BTSC10/WarpESC/README.md

# WarpESC
An open source 2 channel 50A ESC designed for a 2-4S LiPo Battery.
The design utilises a STM32F303 and 6 SIC634CD-T1-GE3 power stages to produce the 3 phase voltages.
