BTSC10/WarpESC/Kicad_Files/WarpESC.kicad_pcb

## KiCad design Kicad_Files/WarpESC.kicad_pcb (2022-10-20)

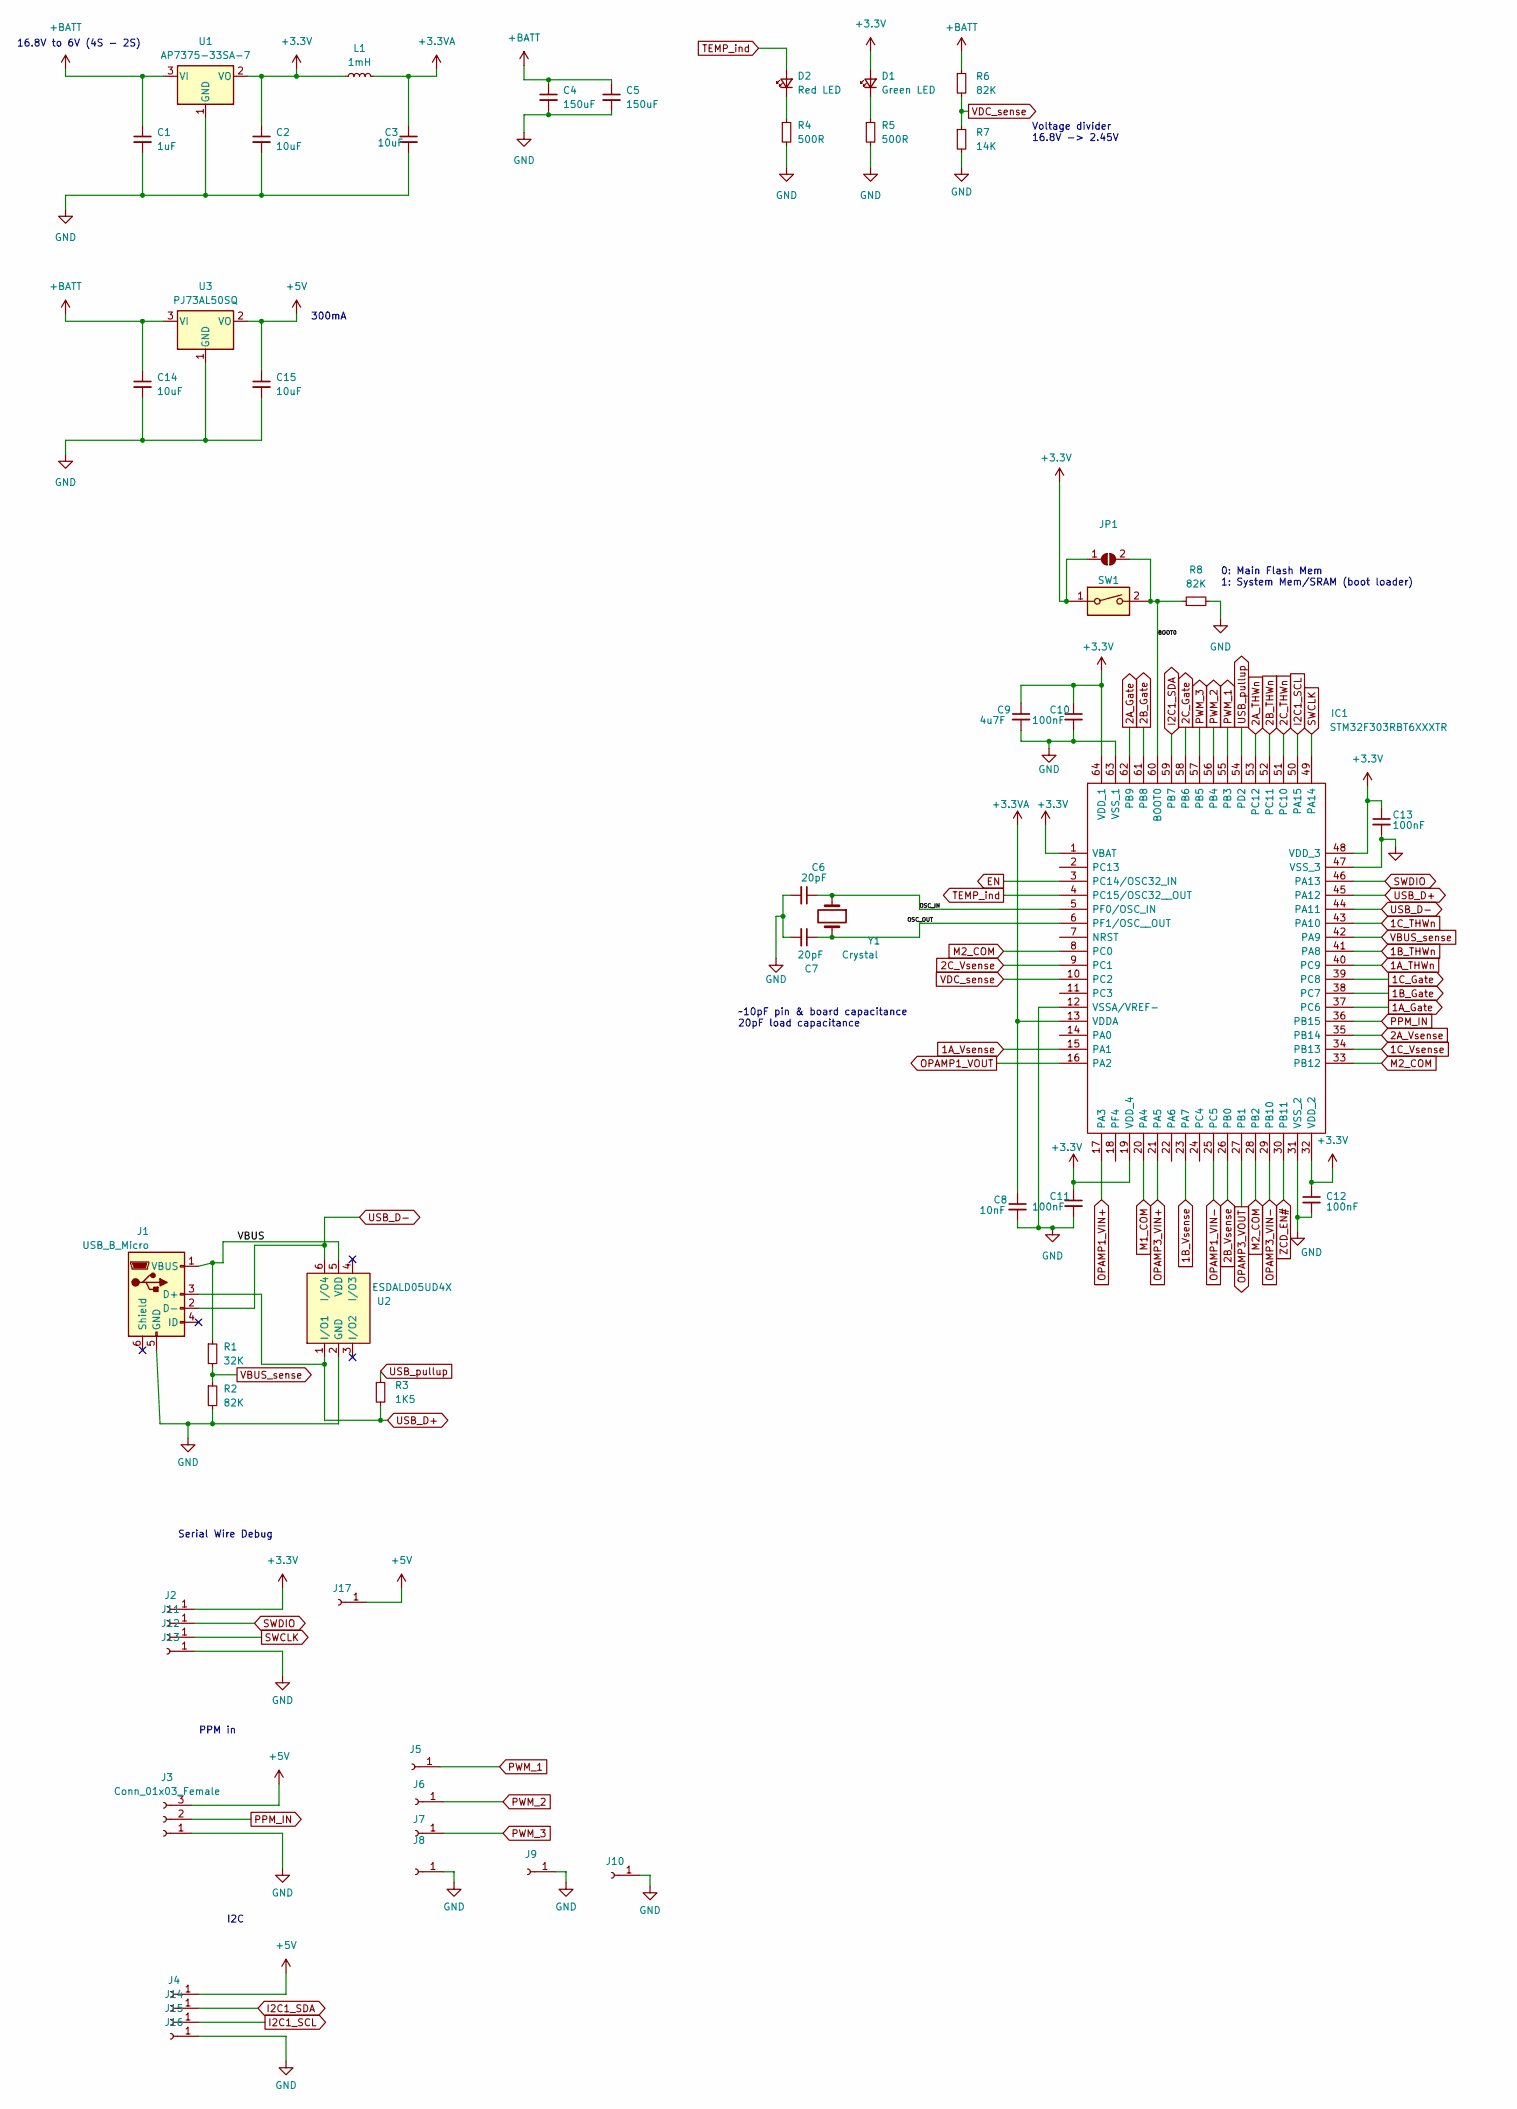
[picture p1: schematic WarpESC.kicad_sch, part in row 1, column 1]

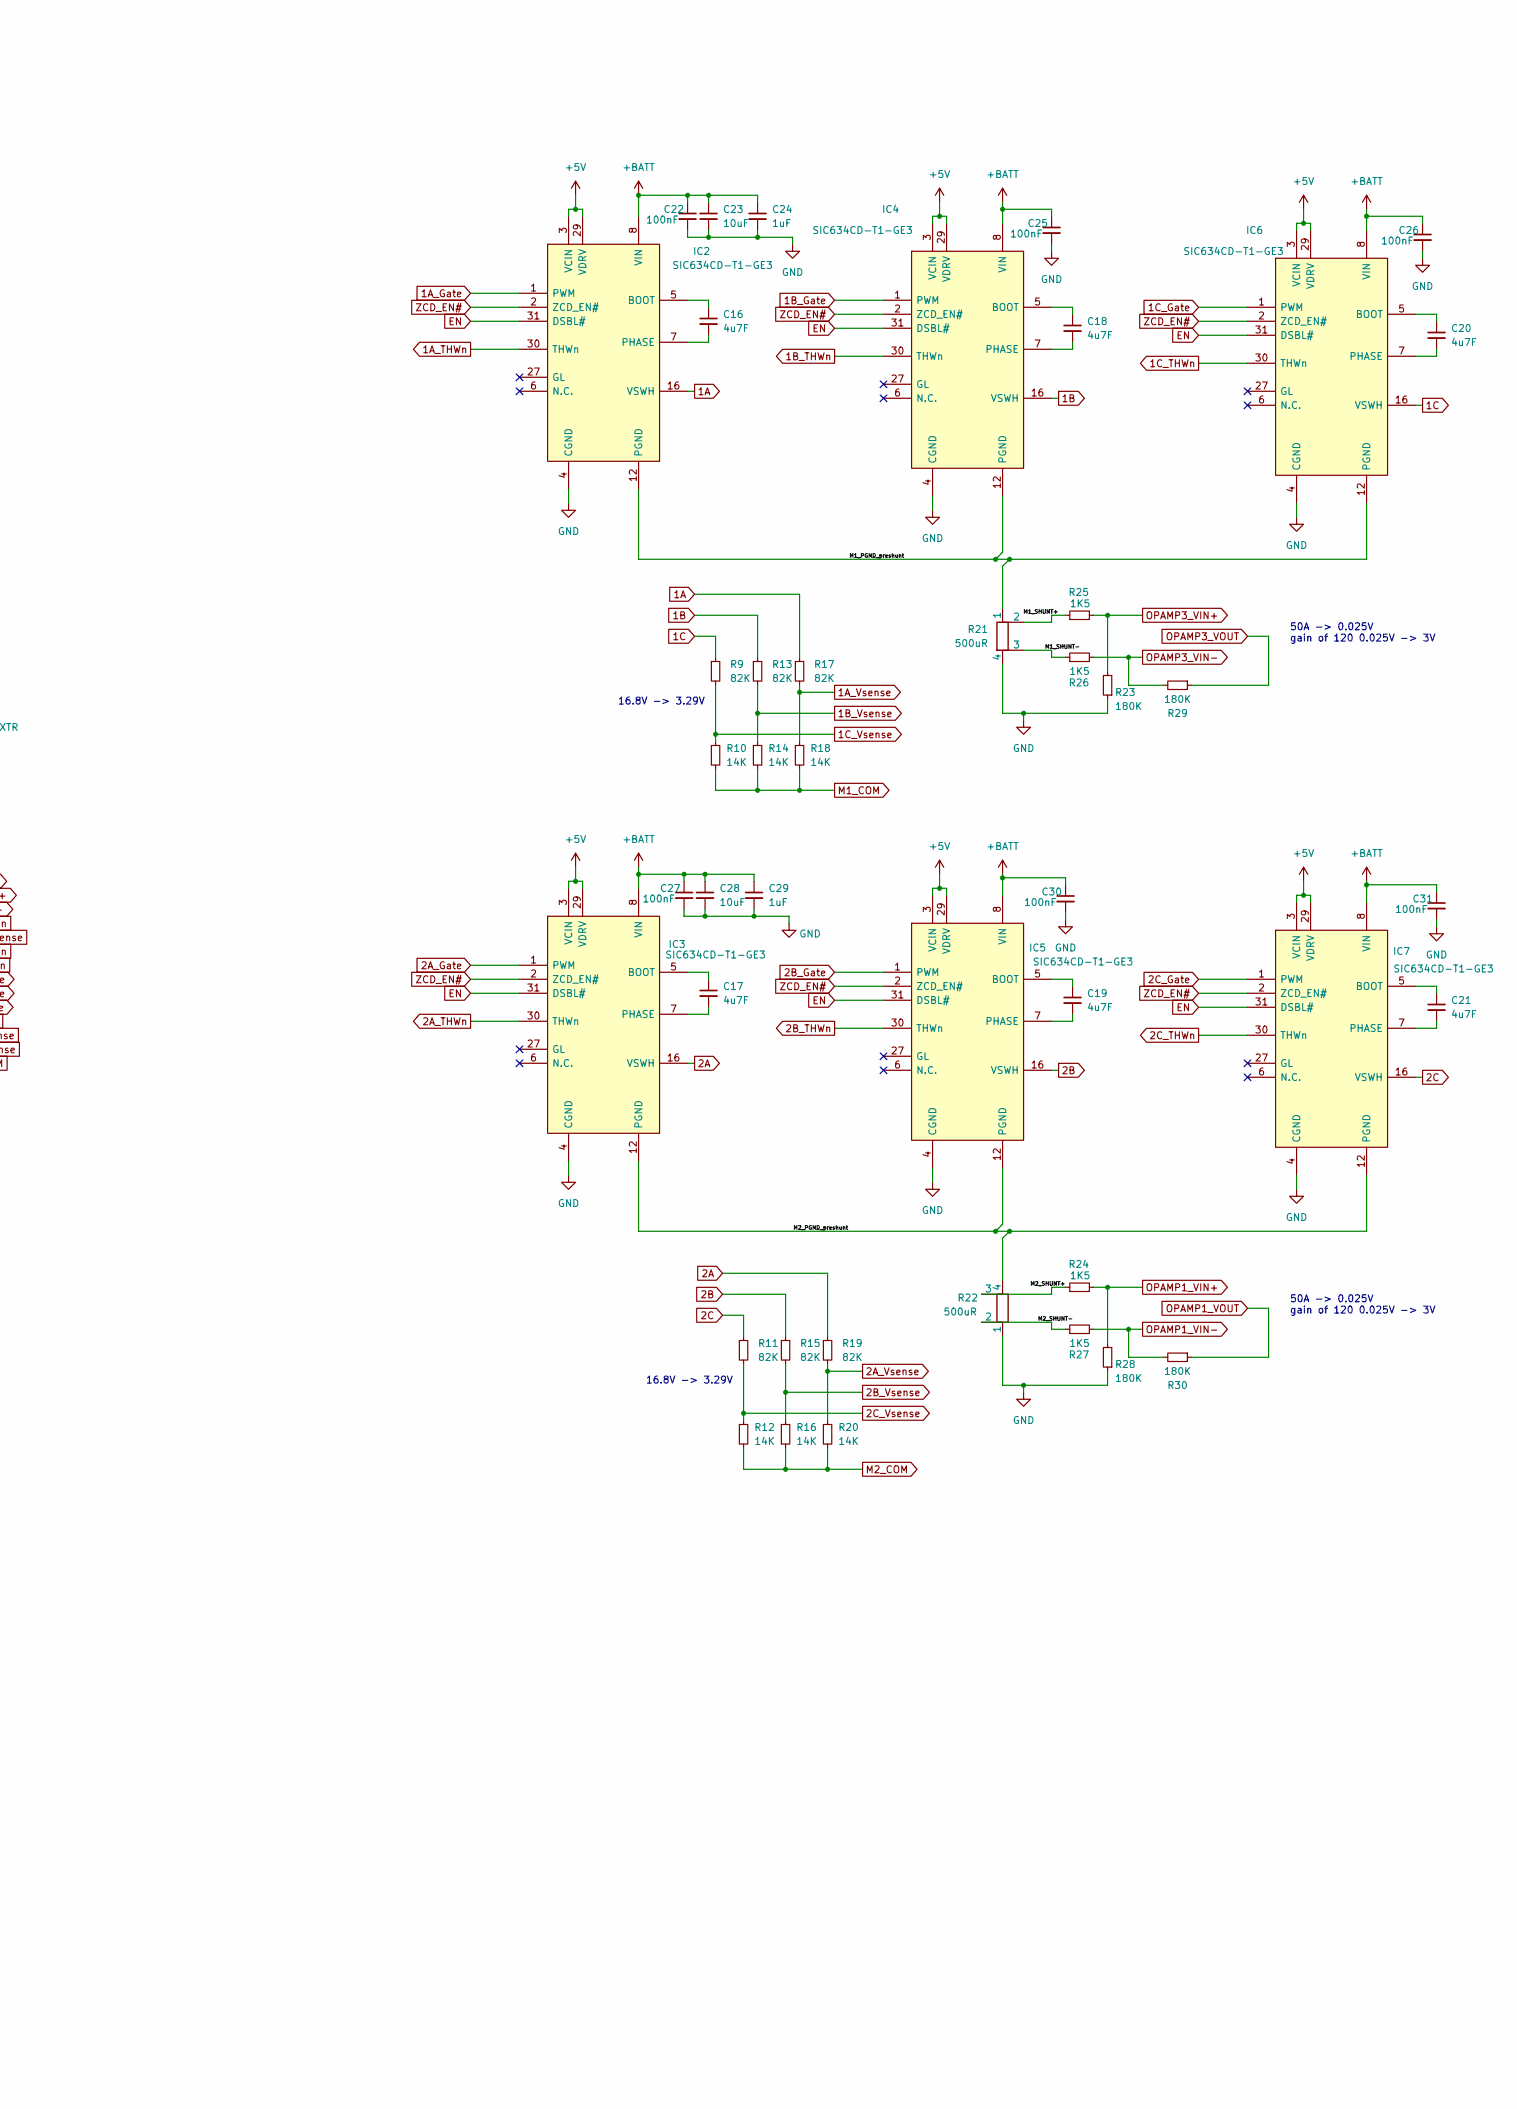
[picture p2: schematic WarpESC.kicad_sch, part in row 1, column 2]

Parts:
C1, C24, C29: 1uF; C_0805_2012Metric
C2, C3, C15: 10uF; C_0402_1005Metric
C4, C5: 150uF
C6, C7: 20pF; C_0402_1005Metric
C8: 10nF; C_0402_1005Metric
C9: 4u7F; C_0603_1608Metric
C10, C11, C12, C13, C22, C25, C26, C27, C30, C31: 100nF; C_0402_1005Metric
C14, C23, C28: 10uF; C_1206_3216Metric
C16, C17, C18, C19, C20, C21: 4u7F; C_0402_1005Metric
D1: Green LED; LED_0603_1608Metric
D2: Red LED; LED_0603_1608Metric
IC1: STM32F303RBT6XXXTR; LQFP-64_10x10mm_P0.5mm; Manufacturer_Part_Number STM32F303RBT6XXXTR
IC2, IC3, IC4, IC5, IC6, IC7: SIC634CD-T1-GE3; SIC634CDT1GE3; Manufacturer_Part_Number SIC634CD-T1-GE3; Mouser Part Number 78-SIC634CD-T1-GE3
J1: USB_B_Micro; USB-MR-D-015
J2, J4, J5, J6, J7, J8, J9, J10, J12, J13, J15, J16, J17: Conn_01x01_Female; SolderWirePad_1x01_SMD_1x2mm
J3: Conn_01x03_Female; PinHeader_1x03_P2.54mm_Vertical
J11, J14: VV; SolderWirePad_1x01_SMD_1x2mm
JP1: SolderJumper_2_Open; SolderJumper-2_P1.3mm_Open_RoundedPad1.0x1.5mm
L1: 1mH; L_1210_3225Metric
R1: 32K; R_0402_1005Metric
R2, R6, R8, R9, R11, R13, R15, R17, R19: 82K; R_0402_1005Metric
R3, R24, R25, R26, R27: 1K5; R_0402_1005Metric
R4, R5: 500R; R_0805_2012Metric
R7, R10, R12, R14, R16, R18, R20: 14K; R_0402_1005Metric
R21, R22: 500uR; WSK12161L000FEA
R23, R28, R29, R30: 180K; R_0402_1005Metric
SW1: DS04-254-2-01BK-SMT; DS04-254-SMT
U1: AP7375-33SA-7; SOT-23
U2: ESDALD05UD4X; SOT-23-6
U3: PJ73AL50SQ; SOT-89-3
Y1: Crystal; Crystal_SMD_3225-4Pin_3.2x2.5mm

Connections:
1A: IC2.16 (VSWH), R17.1
1A_Gate: IC1.37 (PC6), IC2.1 (PWM)
1A_THWn: IC1.40 (PC9), IC2.30 (THWn)
1A_Vsense: IC1.15 (PA1), R17.2, R18.1
1B: IC4.16 (VSWH), R13.1
1B_Gate: IC1.38 (PC7), IC4.1 (PWM)
1B_THWn: IC1.41 (PA8), IC4.30 (THWn)
1B_Vsense: IC1.23 (PA7), R13.2, R14.1
1C: IC6.16 (VSWH), R9.1
1C_Gate: IC1.39 (PC8), IC6.1 (PWM)
1C_THWn: IC1.43 (PA10), IC6.30 (THWn)
1C_Vsense: IC1.34 (PB13), R9.2, R10.1
2A: IC3.16 (VSWH), R19.1
2A_Gate: IC1.62 (PB9), IC3.1 (PWM)
2A_THWn: IC1.53 (PC12), IC3.30 (THWn)
2A_Vsense: IC1.35 (PB14), R19.2, R20.1
2B: IC5.16 (VSWH), R15.1
2B_Gate: IC1.61 (PB8), IC5.1 (PWM)
2B_THWn: IC1.52 (PC11), IC5.30 (THWn)
2B_Vsense: IC1.26 (PB0), R15.2, R16.1
2C: IC7.16 (VSWH), R11.1
2C_Gate: IC1.58 (PB6), IC7.1 (PWM)
2C_THWn: IC1.51 (PC10), IC7.30 (THWn)
2C_Vsense: IC1.9 (PC1), R11.2, R12.1
+3.3VA: C3.1, C8.1, IC1.13 (VDDA), L1.2
+3V3: C2.1, C9.1, C10.1, C11.1, C12.1, C13.1, D1.2 (A), IC1.1 (VBAT), IC1.19 (VDD_4), IC1.32 (VDD_2), IC1.48 (VDD_3), IC1.64 (VDD_1), J2.1, JP1.1 (A), L1.1, SW1.1, U1.2 (VO)
+5V: C15.1, IC2.3 (VCIN), IC2.29 (VDRV), IC3.3 (VCIN), IC3.29 (VDRV), IC4.3 (VCIN), IC4.29 (VDRV), IC5.3 (VCIN), IC5.29 (VDRV), IC6.3 (VCIN), IC6.29 (VDRV), IC7.3 (VCIN), IC7.29 (VDRV), J3.3, J4.1, J17.1, U3.2 (VO)
+BATT: C1.1, C4.1, C5.1, C14.1, C22.1, C23.1, C24.1, C25.1, C26.1, C27.1, C28.1, C29.1, C30.1, C31.1, IC2.8 (VIN), IC3.8 (VIN), IC4.8 (VIN), IC5.8 (VIN), IC6.8 (VIN), IC7.8 (VIN), R6.1, U1.3 (VI), U3.3 (VI)
/BOOT0: IC1.60 (BOOT0), JP1.2 (B), R8.1, SW1.2
/M1_PGND_preshunt: IC2.12 (PGND), IC4.12 (PGND), IC6.12 (PGND), R21.1
/M1_SHUNT+: R21.2, R25.1
/M1_SHUNT-: R21.3, R26.1
/M2_PGND_preshunt: IC3.12 (PGND), IC5.12 (PGND), IC7.12 (PGND), R22.4
/M2_SHUNT+: R22.3, R24.1
/M2_SHUNT-: R22.2, R27.1
/OSC_IN: C6.1, IC1.5 (PF0/OSC_IN), Y1.1
/OSC_OUT: C7.1, IC1.6 (PF1/OSC__OUT), Y1.3
/VBUS: J1.1 (VBUS), R1.1, U2.5 (VDD)
EN: IC1.3 (PC14/OSC32_IN), IC2.31 (DSBL#), IC3.31 (DSBL#), IC4.31 (DSBL#), IC5.31 (DSBL#), IC6.31 (DSBL#), IC7.31 (DSBL#)
GND: C1.2, C2.2, C3.2, C4.2, C5.2, C6.2, C7.2, C8.2, C9.2, C10.2, C11.2, C12.2, C13.2, C14.2, C15.2, C22.2, C23.2, C24.2, C25.2, C26.2, C27.2, C28.2, C29.2, C30.2, C31.2, IC1.12 (VSSA/VREF-), IC1.31 (VSS_2), IC1.47 (VSS_3), IC1.63 (VSS_1), IC2.4 (CGND), IC3.4 (CGND), IC4.4 (CGND), IC5.4 (CGND), IC6.4 (CGND), IC7.4 (CGND), J1.5 (GND), J3.1, J8.1, J9.1, J10.1, J13.1, J16.1, R2.2, R4.2, R5.2, R7.2, R8.2, R21.4, R22.1, R23.1, R28.1, U1.1 (GND), U2.2 (GND), U3.1 (GND)
I2C1_SCL: IC1.50 (PA15), J15.1
I2C1_SDA: IC1.59 (PB7), J14.1
M1_COM: IC1.20 (PA4), R10.2, R14.2, R18.2
M2_COM: IC1.8 (PC0), IC1.28 (PB2), IC1.33 (PB12), R12.2, R16.2, R20.2
unnamed: C16.1, IC2.5 (BOOT)
unnamed: C16.2, IC2.7 (PHASE)
unnamed: C17.1, IC3.5 (BOOT)
unnamed: C17.2, IC3.7 (PHASE)
unnamed: C18.1, IC4.5 (BOOT)
unnamed: C18.2, IC4.7 (PHASE)
unnamed: C19.1, IC5.5 (BOOT)
unnamed: C19.2, IC5.7 (PHASE)
unnamed: C20.1, IC6.5 (BOOT)
unnamed: C20.2, IC6.7 (PHASE)
unnamed: C21.1, IC7.5 (BOOT)
unnamed: C21.2, IC7.7 (PHASE)
unnamed: D1.1 (K), R5.1
unnamed: D2.1 (K), R4.1
OPAMP1_VIN+: IC1.17 (PA3), R24.2, R28.2
OPAMP1_VIN-: IC1.25 (PC5), R27.2, R30.2
OPAMP1_VOUT: IC1.16 (PA2), R30.1
OPAMP3_VIN+: IC1.21 (PA5), R23.2, R25.2
OPAMP3_VIN-: IC1.29 (PB10), R26.2, R29.2
OPAMP3_VOUT: IC1.27 (PB1), R29.1
PPM_IN: IC1.36 (PB15), J3.2
PWM_1: IC1.55 (PB3), J5.1
PWM_2: IC1.56 (PB4), J6.1
PWM_3: IC1.57 (PB5), J7.1
SWCLK: IC1.49 (PA14), J12.1
SWDIO: IC1.46 (PA13), J11.1
TEMP_ind: D2.2 (A), IC1.4 (PC15/OSC32__OUT)
USB_D+: IC1.45 (PA12), J1.3 (D+), R3.2, U2.1 (I/O1)
USB_D-: IC1.44 (PA11), J1.2 (D-), U2.6 (I/O4)
USB_pullup: IC1.54 (PD2), R3.1
VBUS_sense: IC1.42 (PA9), R1.2, R2.1
VDC_sense: IC1.10 (PC2), R6.2, R7.1
ZCD_EN#: IC1.30 (PB11), IC2.2 (ZCD_EN#), IC3.2 (ZCD_EN#), IC4.2 (ZCD_EN#), IC5.2 (ZCD_EN#), IC6.2 (ZCD_EN#), IC7.2 (ZCD_EN#)

Notes on the sheet:
Serial Wire Debug
16.8V -> 3.29V
16.8V to 6V (4S - 2S)
50A -> 0.025V gain of 120 0.025V -> 3V
0: Main Flash Mem 1: System Mem/SRAM (boot loader)
300mA
~10pF pin & board capacitance 20pF load capacitance
PPM in
I2C
Voltage divider 16.8V -> 2.45V

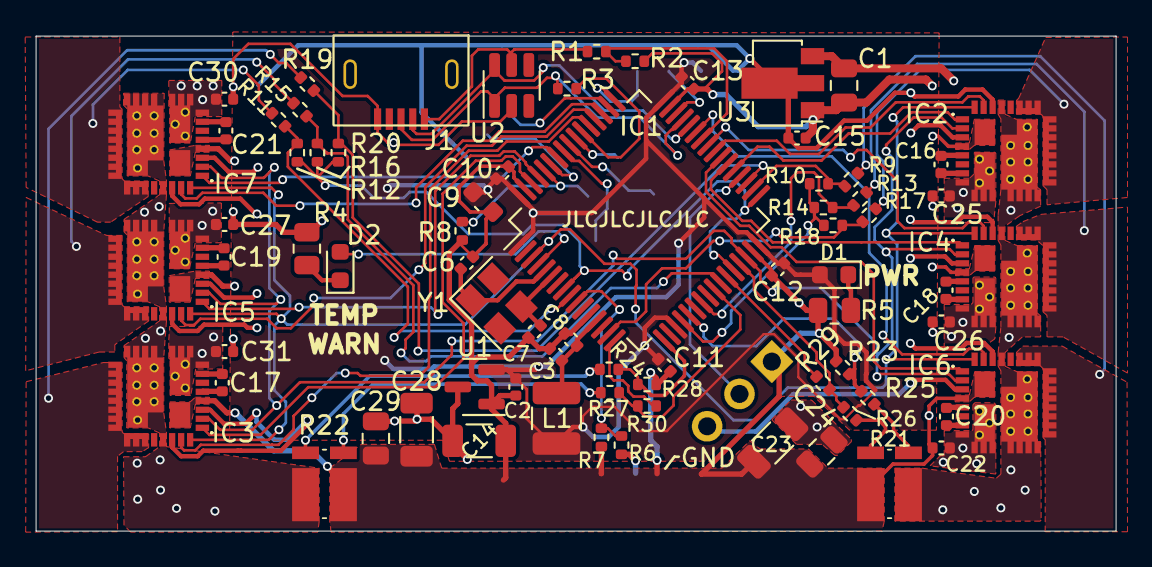
[picture p3: board WarpESC.kicad_pcb from above]

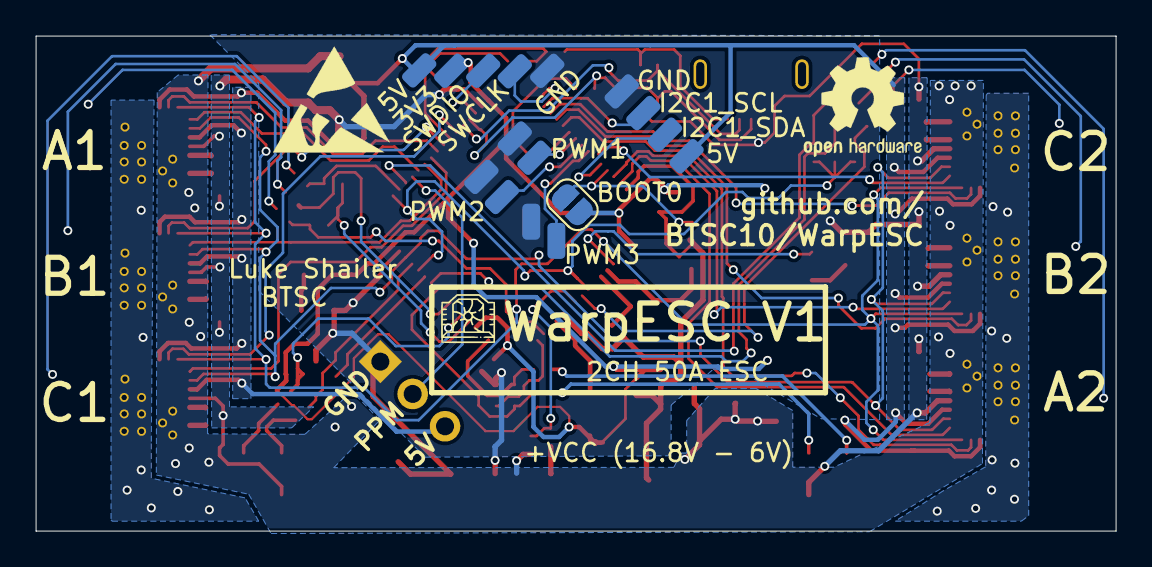
[picture p4: board WarpESC.kicad_pcb from below]

Board: 2 copper layers, 60.0 x 27.5 mm, 91 parts (16 on the bottom side), 77 nets.
