BTSC10/WarpESC/(threads)

Thread 3 (2022-10-24):

Cannot Interface with ST-LINK

BTSC10, 2022-10-24:
While trying to use the ST-LINK built into the Nucleo development board, the STM32 is unresponsive and the ST-LINK produces a FAIL.TXT file containing the text "The interface firmware FAILED to reset/halt the target MCU".

Setup:
CN2 jumpers removed, JP5 set to E5V, CN4 pin 1 connected to 3V3, pin 2 to SWCLK, pin 3 to Ground, pin 4 to SWDIO, pin 5 to NRST. WarpESC powered by external 3V3. common ground between ST-LINK and WarpESC.
BOOT0 pulled low, HSE not connected.

BTSC10, 2022-10-24:
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

SWD may not be active by default

BTSC10, 2022-10-25:
STM32 was mounted 180 degrees from intended orientation and was non-functional even after being correctly mounted. SWD using ST-LINK works on a new board

Closed 2022-10-25.

Thread 4 (2022-10-24):

No OSC_IN signal

BTSC10, 2022-10-24:
There is no OSC_IN or OSC_OUT signal. both pins seem to have a high impedance. Is this because by default the HSE clock is disabled? Does the STM32 rely on the internal HSI oscillator before it has been flashed for the first time?

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

BTSC10, 2022-10-26:
HSE works once configured

Closed 2022-10-26.

Thread 5 (2022-11-02):

Power Stage needs 5 V logic inputs

BTSC10, 2022-11-02:
The stm32 can only output 3.3 V logic levels but the power stage needs a minimum of 4.5 V

BTSC10, 2022-11-05:
The power stages seem to behave as expected when powered from 3.3 V and fed 3.3 V control signals.
It would still be nice to implement a level shifter for robustness

Thread 6 (2022-11-02):

Power Stage does not pull Vswh up to Vin

BTSC10, 2022-11-02:
Conditions:
V<sub>in</sub>, V<sub>drv</sub>, V<sub>cin</sub>, ZCD_EN#, and DSBL# at 5 V.
P<sub>gnd</sub> and C<sub>gnd</sub> grounded.

Behaviour:
When PWM is low there is a low resistance path between V<sub>swh</sub> and GND but when PWM is at 5 V, V<sub>swh</sub> reads a voltage of about 3.6 V

Resources:
https://www.vishay.com/docs/76784/sic634.pdf

BTSC10, 2022-11-04:
This might just be the bootstrap Caps discharging?

BTSC10, 2022-11-05:
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
This issue is just a result of the bootstrap Caps discharging.
At higher frequencies the power stage acts as expected.

Closed 2022-11-05.
