BTSC10/WarpESC/CubeIDE_files/WarpESC.ioc

Mcu.UserName=STM32F303RBTx
PA1.Signal=SharedAnalog_PA1
PA10.GPIO_Label=C1_THWn
PA10.Signal=GPIO_Input
PA11.Signal=USB_DM
PA12.Signal=USB_DP
PA13.Signal=SYS_JTMS-SWDIO
PA14.Signal=SYS_JTCK-SWCLK
PA15.Signal=I2C1_SCL
PA2.Signal=SharedAnalog_PA2
PA3.Signal=OPAMP1_VINP
PA4.Signal=SharedAnalog_PA4
PA5.Signal=OPAMP3_VINP
PA7.Signal=SharedAnalog_PA7
PA8.GPIO_Label=B1_THWn
PA8.Signal=GPIO_Input
PB0.Signal=SharedAnalog_PB0
PB1.Signal=SharedAnalog_PB1
PB10.Signal=OPAMP3_VINM
PB11.Signal=GPIO_Output
PB12.Signal=COMP3_INM
PB13.Signal=SharedAnalog_PB13
PB14.Signal=SharedAnalog_PB14
PB15.GPIO_Label=PPM_IN
PB15.Signal=GPIO_Input
PB2.Signal=COMP4_INM
PB3.GPIO_Label=PWM1
PB3.Signal=GPIO_Input
PB4.GPIO_Label=PWM2
PB4.Signal=GPIO_Input
PB5.GPIO_Label=PWM3
PB5.Signal=GPIO_Output
PB6.Signal=S_TIM8_CH1
PB7.Signal=I2C1_SDA
PB8.Signal=S_TIM8_CH2
PB9.Signal=S_TIM8_CH3
PC0.Signal=COMP7_INM
PC1.Signal=COMP7_INP
PC10.GPIO_Label=C2_THWn
PC10.Signal=GPIO_Input
PC11.GPIO_Label=B2_THWn
PC11.Signal=GPIO_Input
PC12.GPIO_Label=A2_THWn
PC12.Signal=GPIO_Input
PC14-OSC32_IN.GPIO_Label=EN
PC14-OSC32_IN.Signal=GPIO_Output
PC15-OSC32_OUT.GPIO_Label=TEMP_ind
PC15-OSC32_OUT.Signal=GPIO_Output
PC2.Signal=ADCx_IN8
PC5.Signal=OPAMP1_VINM
PC6.Signal=S_TIM3_CH1
PC7.Signal=S_TIM3_CH2
PC8.Signal=S_TIM3_CH3
PC9.GPIO_Label=A1_THWn
PC9.Signal=GPIO_Input
PD2.GPIO_Label=USB_pullup
PD2.Signal=GPIO_Output
PF0-OSC_IN.Signal=RCC_OSC_IN
PF1-OSC_OUT.Signal=RCC_OSC_OUT
