BTSC10/WarpESC/(commit log)

2022-10-20 Add gerber and kicad files
    [ESC-B_Cu.gbr, ESC-B_Mask.gbr, ESC-B_Paste.gbr, ESC-B_Silkscreen.gbr, ESC-Edge_Cuts.gbr, ESC-F_Cu.gbr, ESC-F_Mask.gbr, ESC-F_Paste.gbr]
2022-10-20 Uploading first CubeIDE files
    Only contains pinout for the stm32
2022-10-20 Initial CubeIDE files
    Doesn't contain any code, just the pinout for the stm32
    [WarpESC.ioc]
